AvaotaSBC/AvaotaF1/Hardware/05_BOM/BOM_Avaota F1_PCB1_2025-04-17.xlsx

No. | Device | Name | Designator | Value | Footprint | Manufacturer | Manufacturer Part | Supplier | Supplier Part | Quantity | JLCPCB Price | Pins | Primary Category | Secondary Category | Comment
1 | 2.54PHSM-1X15P |  | H4,H5 |  | 2.54PHSM-1X15P | kinghelm(金航标) | KH-2.54PH180-1X16P-L11.5 | LCSC | C2905491 | 2 | 1.0128 | 30 |  |  | KH-2.54PH180-1X16P-L11.5
2 | 0402ESDA-05N | 0402ESDA-05N | D1,D2 |  | D0402 | BORN(伯恩半导体) | 0402ESDA-05N | LCSC | C316049 | 2 | 0.122 | 2 |  |  | 0402ESDA-05N
3 | AFC11-S16ICC-00 | AFC11-S16ICC-00 | P1 |  | FPC-SMD_16P-L13.5-W2.0-P0.50 | JS(钜硕电子) | AFC11-S16ICC-00 | LCSC | C11071 | 1 | 0.596 | 18 | 连接器 | FFC/FPC连接器 | AFC11-S16ICC-00
4 | CA-C03 | CA-C03 | ANT1 |  | ANT-SMD_CA-C03 |  | CA-C03 | LCSC | C2838842 | 1 | 0.004 | 2 |  |  | CA-C03
5 | CAP_0402 | 100nF | C53,C54,C55,C56,C57,C58,C59,C60,C61,C63 | 100nF | C0402-NSK |  |  |  |  | 10 |  | 2 |  |  | 100nF
6 | CAP_0603 | 22uF | C43,C44,C45,C46,C47,C48,C49,C50,C51,C52 | 22uF | C0603-NSK |  |  |  |  | 10 |  | 2 |  |  | 22uF
7 | CKCS201610-2.2uH/M | 2.2uH | L1,L2,L3 | 2.2uH | IND-SMD_L2.0-W1.6 | CENKER(岑科) | CKCS201610-2.2uH/M | LCSC | C354533 | 3 | 0.233 | 2 | Inductors/Coils/Transformers | Power Inductors | 2.2uH
8 | CL03A104KQ3NNNC | 1uF | C2,C3,C4 | 1uF | C0201 NSK | SAMSUNG(三星) | CL03A104KQ3NNNC | LCSC |  | 3 |  | 2 | 电容 | 贴片电容(MLCC) | 1uF
9 | CL03A104KQ3NNNC | 2.2uF | C25 | 2.2uF | C0201 NSK | SAMSUNG(三星) | CL03A104KQ3NNNC | LCSC |  | 1 |  | 2 | 电容 | 贴片电容(MLCC) | 2.2uF
10 | CL03A104KQ3NNNC | 4.7uF | C1,C29 | 4.7uF | C0201 NSK | SAMSUNG(三星) | CL03A104KQ3NNNC | LCSC |  | 2 |  | 2 | 电容 | 贴片电容(MLCC) | 4.7uF
11 | CL03A104KQ3NNNC | 10pF | C11,C12 | 10pF | C0201 NSK | SAMSUNG(三星) | CL03A104KQ3NNNC | LCSC |  | 2 |  | 2 | 电容 | 贴片电容(MLCC) | 10pF
12 | CL03A104KQ3NNNC | 33pF | C30,C31 | 33pF | C0201 NSK | SAMSUNG(三星) | CL03A104KQ3NNNC | LCSC |  | 2 |  | 2 | 电容 | 贴片电容(MLCC) | 33pF
13 | CL03A104KQ3NNNC | 100nF | C5,C10,C13,C14,C15,C16,C17,C18,C19,C20,C21,C22,C23,C24,C27,C28,C32,C33,C34,C35,C37,C38,C39,C40,C41,C42,C62 | 100nF | C0201 NSK | SAMSUNG(三星) | CL03A104KQ3NNNC | LCSC | C160831 | 27 | 0.0072 | 2 | 电容 | 贴片电容(MLCC) | 100nF
14 | CL03A104KQ3NNNC | 470nF | C26 | 470nF | C0201 NSK | SAMSUNG(三星) | CL03A104KQ3NNNC | LCSC |  | 1 |  | 2 | 电容 | 贴片电容(MLCC) | 470nF
15 | EA3036CQBR | EA3036CQBR | U3 |  | WQFN-20_L3.0-W3.0-P0.40-BL-EP | everanalog(申风) | EA3036CQBR | LCSC | C570857 | 1 | 1.505 | 21 | 电源管理 | 专业电源管理(PMIC) | EA3036CQBR
16 | HDR-F_2.54_1x2P |  | H3 |  | HDR-TH_2P-P2.54-V-F | BOOMELE(博穆精密) | 2.54-1*2P母 | LCSC | C49661 | 1 | 0.248 | 2 | 连接器 | 排母 | 2.54-1*2P母
17 | LED_0807-RGB |  | LED1 |  | RGBLED_0807 |  |  |  |  | 1 |  | 2 |  |  | LED_0807-RGB
18 | MIC-4013-G-G00 | MIC-4013-G-G00 | MIC1 |  | MIC-SMD_MIC-4013-G-G00 | SAMZO(三佐) | MIC-4013-G-G00 | LCSC | C42371093 | 1 | 0.537 | 2 | 音频器件/振动马达 | 咪头/麦克风 | MIC-4013-G-G00
19 | MUP-M617-2 | MUP-M617-2 | U2 |  | TF-SMD_MUP-M617-2 | MUP(德海威) | MUP-M617-2 | LCSC | C5205359 | 1 | 2.41 | 12 | 连接器 | SD卡连接器 | MUP-M617-2
20 | PY25Q128HA-SUH-IT | PY25Q128HA-SUH-IT | U4 |  | SOP-8_L5.2-W5.3-P1.27-LS7.9-BL | PUYA(普冉) | PY25Q128HA-SUH-IT | LCSC | C7419750 | 1 | 3.89 | 8 | 存储器 | NOR FLASH | PY25Q128HA-SUH-IT
21 | Q22FA12800489 | 40MHz | X1 | 40MHz | osc-smd_4p-l2.0-w1.6-bl | EPSON(爱普生) | Q22FA12800489 | LCSC |  | 1 |  | 4 | 晶振/振荡器/谐振器 | 无源晶振 | 40MHz
22 | Res_0201 | 0 | R2,R3 | 0 | R0201 NSK |  |  |  |  | 2 |  | 2 |  |  | 0
23 | Res_0201 | 1K | R22,R23 | 1K | R0201 NSK |  |  |  |  | 2 |  | 2 |  |  | 1K
24 | Res_0201 | 1.5K | R18,R19 | 1.5K | R0201 NSK |  |  |  |  | 2 |  | 2 |  |  | 1.5K
25 | Res_0201 | 2K | R24,R25 | 2K | R0201 NSK |  |  |  |  | 2 |  | 2 |  |  | 2K
26 | Res_0201 | 5.1K | R6,R15,R16 | 5.1K | R0201 NSK |  |  |  |  | 3 |  | 2 |  |  | 5.1K
27 | Res_0201 | 10K | R8,R14,R17,R26 | 10K | R0201 NSK |  |  |  |  | 4 |  | 2 |  |  | 10K
28 | Res_0201 | 33 | R4,R5,R20,R21 | 33 | R0201 NSK |  |  |  |  | 4 |  | 2 |  |  | 33
29 | Res_0201 | 75K | R12 | 75K | R0201 NSK |  |  |  |  | 1 |  | 2 |  |  | 75K
30 | Res_0201 | 100K | R11,R13 | 100K | R0201 NSK |  |  |  |  | 2 |  | 2 |  |  | 100K
31 | Res_0201 | 150K | R9,R10 | 150K | R0201 NSK |  |  |  |  | 2 |  | 2 |  |  | 150K
32 | Res_0201 | 680K | R7 | 680K | R0201 NSK |  |  |  |  | 1 |  | 2 |  |  | 680K
33 | Res_0201 | NC | R1 | NC | R0201 NSK |  |  |  |  | 1 |  | 2 |  |  | NC
34 | Res_0402 | 1 | R27 | 1 | R0402-NSK |  |  |  |  | 1 |  | 2 | 电阻 | 贴片电阻 | 1
35 | TS3425BA | TS3425BA | SW1 |  | SW-SMD_4P-L4.2-W3.2-P2.15-LS4.6-1 | SHOU HAN(首韩) | TS3425BA | LCSC | C2681476 | 1 | 0.226 | 4 | 按键/开关 | 轻触开关 | TS3425BA
36 | TYPE-C 16P QTGM027 | TYPE-C 16P QTGM027 | USB1 |  | USB-C-SMD_TYPE-C-16P-QTGM027 | SHOU HAN(首韩) | TYPE-C 16P QTGM027 | LCSC | C2681552 | 1 | 1.0483 | 16 | 连接器 | USB连接器 | TYPE-C 16P QTGM027
37 | V821x2-xXX | V821x2-xXX | U1 |  | QFN-88_L9.0-W9.0-P0.35-BL-EP5.26 |  |  |  |  | 1 |  | 89 |  |  | V821x2-xXX
