AvaotaSBC/AvaotaF1/Hardware/01_SCH/SCH_Main_2025-04-17.pdf

14 14 13 13 12 12 11 11 10 10 9

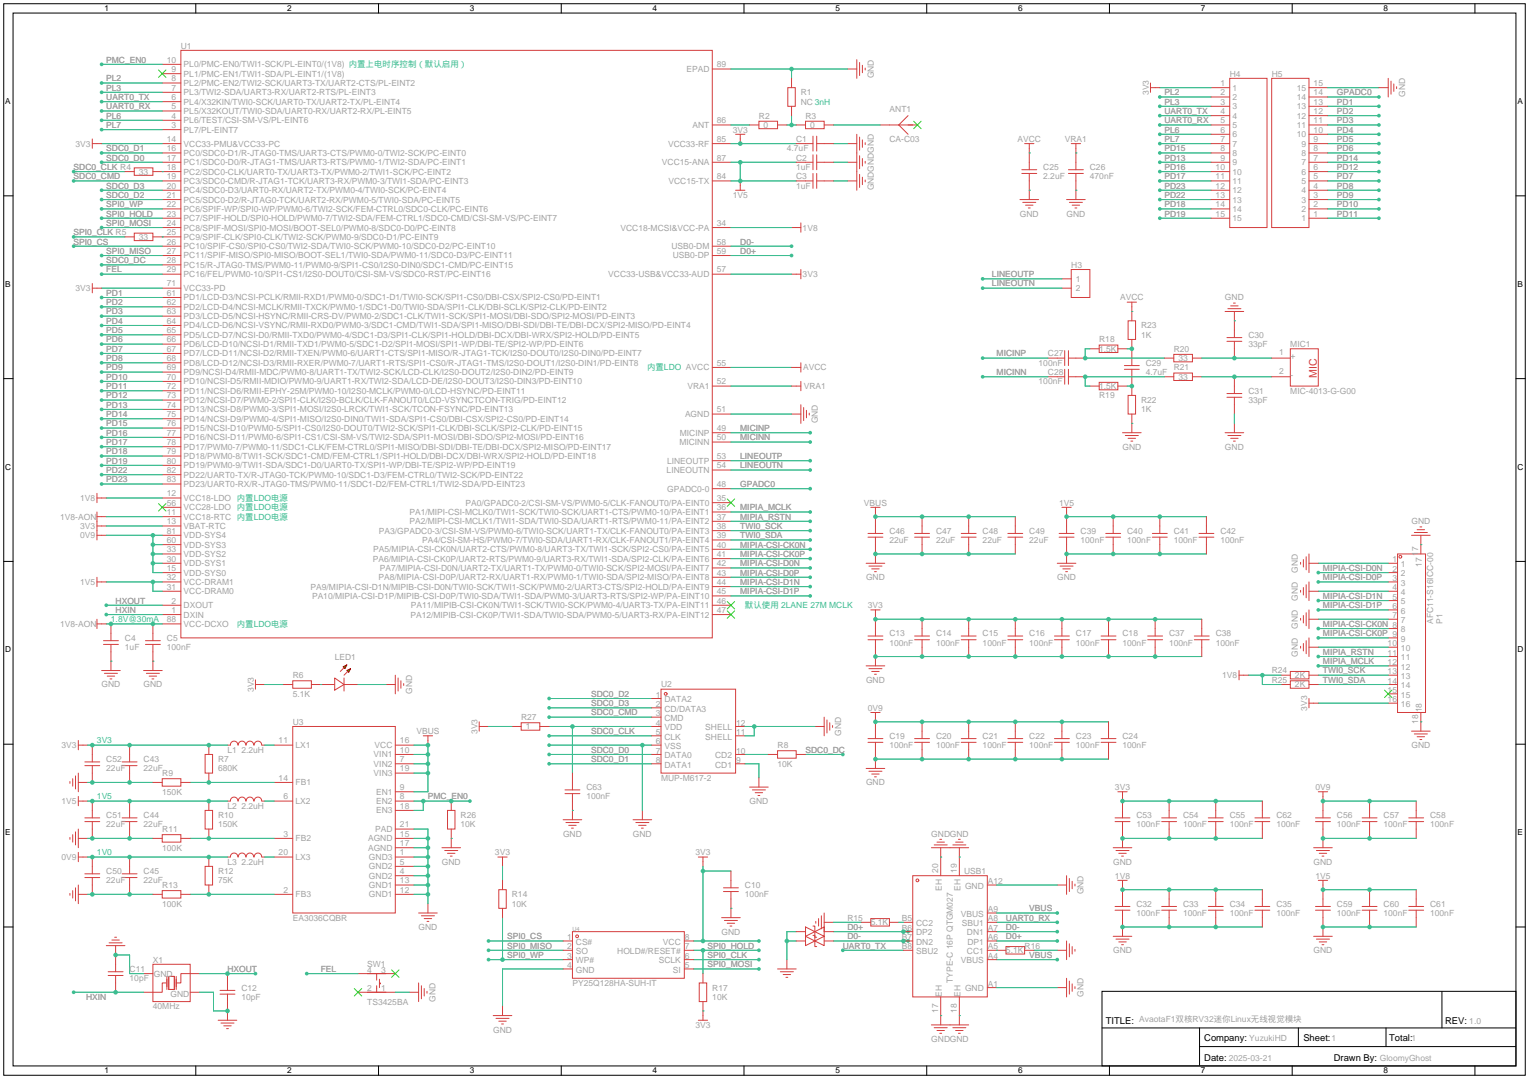
[picture p3: page 1]

PL0/PMC-EN0/TWI1-SCK/PL-EINT0/(1V8) 10
PL1/PMC-EN1/TWI1-SDA/PL-EINT1/(1V8) 9
PL2/PMC-EN2/TWI2-SCK/UART3-TX/UART2-CTS/PL-EINT2 8
PL3/TWI2-SDA/UART3-RX/UART2-RTS/PL-EINT3 7
PL4/X32KIN/TWI0-SCK/UART0-TX/UART2-TX/PL-EINT4 6
PL5/X32KOUT/TWI0-SDA/UART0-RX/UART2-RX/PL-EINT5 5
PL6/TEST/CSI-SM-VS/PL-EINT6 4
PL7/PL-EINT7 3
PC16/FEL/PWM0-10/SPI1-CS1/I2S0-DOUT0/CSI-SM-VS/SDC0-RST/PC-EINT16 29 PC15/R-JTAG0-TMS/PWM0-11/PWM0-9/SPI1-CS0/I2S0-DIN0/SDC1-CMD/PC-EINT15 28 PC11/SPIF-MISO/SPI0-MISO/BOOT-SEL1/TWI0-SDA/PWM0-11/SDC0-D3/PC-EINT11 27 PC10/SPIF-CS0/SPI0-CS0/TWI2-SDA/TWI0-SCK/PWM0-10/SDC0-D2/PC-EINT10 26 PC9/SPIF-CLK/SPI0-CLK/TWI2-SCK/PWM0-9/SDC0-D1/PC-EINT9 25 PC8/SPIF-MOSI/SPI0-MOSI/BOOT-SEL0/PWM0-8/SDC0-D0/PC-EINT8 24 PC7/SPIF-HOLD/SPI0-HOLD/PWM0-7/TWI2-SDA/FEM-CTRL1/SDC0-CMD/CSI-SM-VS/PC-EINT7 23 PC6/SPIF-WP/SPI0-WP/PWM0-6/TWI2-SCK/FEM-CTRL0/SDC0-CLK/PC-EINT6 22 PC5/SDC0-D2/R-JTAG0-TCK/UART2-RX/PWM0-5/TWI0-SDA/PC-EINT5 21 PC4/SDC0-D3/UART0-RX/UART2-TX/PWM0-4/TWI0-SCK/PC-EINT4 20 PC3/SDC0-CMD/R-JTAG1-TCK/UART3-RX/PWM0-3/TWI1-SDA/PC-EINT3 19 PC2/SDC0-CLK/UART0-TX/UART3-TX/PWM0-2/TWI1-SCK/PC-EINT2 18 PC1/SDC0-D0/R-JTAG1-TMS/UART3-RTS/PWM0-1/TWI2-SDA/PC-EINT1 17 PC0/SDC0-D1/R-JTAG0-TMS/UART3-CTS/PWM0-0/TWI2-SCK/PC-EINT0 16 VCC33-PMU&VCC33-PC 14

PD23/UART0-RX/R-JTAG0-TMS/PWM0-11/SDC1-D2/FEM-CTRL1/TWI2-SDA/PD-EINT23 83 PD22/UART0-TX/R-JTAG0-TCK/PWM0-10/SDC1-D3/FEM-CTRL0/TWI2-SCK/PD-EINT22 82 PD19/PWM0-9/TWI1-SDA/SDC1-D0/UART0-TX/SPI1-WP/DBI-TE/SPI2-WP/PD-EINT19 80 PD18/PWM0-8/TWI1-SCK/SDC1-CMD/FEM-CTRL1/SPI1-HOLD/DBI-DCX/DBI-WRX/SPI2-HOLD/PD-EINT18 79 PD17/PWM0-7/PWM0-11/SDC1-CLK/FEM-CTRL0/SPI1-MISO/DBI-SDI/DBI-TE/DBI-DCX/SPI2-MISO/PD-EINT17 78 PD16/NCSI-D11/PWM0-6/SPI1-CS1/CSI-SM-VS/TWI2-SDA/SPI1-MOSI/DBI-SDO/SPI2-MOSI/PD-EINT16 77 PD15/NCSI-D10/PWM0-5/SPI1-CS0/I2S0-DOUT0/TWI2-SCK/SPI1-CLK/DBI-SCLK/SPI2-CLK/PD-EINT15 76 PD14/NCSI-D9/PWM0-4/SPI1-MISO/I2S0-DIN0/TWI1-SDA/SPI1-CS0/DBI-CSX/SPI2-CS0/PD-EINT14 75 PD13/NCSI-D8/PWM0-3/SPI1-MOSI/I2S0-LRCK/TWI1-SCK/TCON-FSYNC/PD-EINT13 74 PD12/NCSI-D7/PWM0-2/SPI1-CLK/I2S0-BCLK/CLK-FANOUT0/LCD-VSYNCTCON-TRIG/PD-EINT12 73 PD11/NCSI-D6/RMII-EPHY-25M/PWM0-10/I2S0-MCLK/PWM0-0/LCD-HSYNC/PD-EINT11 72 PD10/NCSI-D5/RMII-MDIO/PWM0-9/UART1-RX/TWI2-SDA/LCD-DE/I2S0-DOUT3/I2S0-DIN3/PD-EINT10 70 PD9/NCSI-D4/RMII-MDC/PWM0-8/UART1-TX/TWI2-SCK/LCD-CLK/I2S0-DOUT2/I2S0-DIN2/PD-EINT9 69 PD8/LCD-D12/NCSI-D3/RMII-RXER/PWM0-7/UART1-RTS/SPI1-CS0/R-JTAG1-TMS/I2S0-DOUT1/I2S0-DIN1/PD-EINT8 68 PD7/LCD-D11/NCSI-D2/RMII-TXEN/PWM0-6/UART1-CTS/SPI1-MISO/R-JTAG1-TCK/I2S0-DOUT0/I2S0-DIN0/PD-EINT7 67 PD6/LCD-D10/NCSI-D1/RMII-TXD1/PWM0-5/SDC1-D2/SPI1-MOSI/SPI1-WP/DBI-TE/SPI2-WP/PD-EINT6 66 PD5/LCD-D7/NCSI-D0/RMII-TXD0/PWM0-4/SDC1-D3/SPI1-CLK/SPI1-HOLD/DBI-DCX/DBI-WRX/SPI2-HOLD/PD-EINT5 65 PD4/LCD-D6/NCSI-VSYNC/RMII-RXD0/PWM0-3/SDC1-CMD/TWI1-SDA/SPI1-MISO/DBI-SDI/DBI-TE/DBI-DCX/SPI2-MISO/PD-EINT4 64 PD3/LCD-D5/NCSI-HSYNC/RMII-CRS-DV/PWM0-2/SDC1-CLK/TWI1-SCK/SPI1-MOSI/DBI-SDO/SPI2-MOSI/PD-EINT3 63 PD2/LCD-D4/NCSI-MCLK/RMII-TXCK/PWM0-1/SDC1-D0/TWI0-SDA/SPI1-CLK/DBI-SCLK/SPI2-CLK/PD-EINT2 62 PD1/LCD-D3/NCSI-PCLK/RMII-RXD1/PWM0-0/SDC1-D1/TWI0-SCK/SPI1-CS0/DBI-CSX/SPI2-CS0/PD-EINT1 61 VCC33-PD 71

VBAT-RTC 13 VCC18-RTC 11 VCC28-LDO 56 VCC18-LDO 12

PA1/MIPI-CSI-MCLK0/TWI1-SCK/TWI0-SCK/UART1-CTS/PWM0-10/PA-EINT1 36
PA2/MIPI-CSI-MCLK1/TWI1-SDA/TWI0-SDA/UART1-RTS/PWM0-11/PA-EINT2 37
PA3/GPADC0-3/CSI-SM-VS/PWM0-6/TWI0-SCK/UART1-TX/CLK-FANOUT0/PA-EINT3 38
PA5/MIPIA-CSI-CK0N/UART2-CTS/PWM0-8/UART3-TX/TWI1-SCK/SPI2-CS0/PA-EINT5 40
PA6/MIPIA-CSI-CK0P/UART2-RTS/PWM0-9/UART3-RX/TWI1-SDA/SPI2-CLK/PA-EINT6 41
PA7/MIPIA-CSI-D0N/UART2-TX/UART1-TX/PWM0-0/TWI0-SCK/SPI2-MOSI/PA-EINT7 42
PA8/MIPIA-CSI-D0P/UART2-RX/UART1-RX/PWM0-1/TWI0-SDA/SPI2-MISO/PA-EINT8 43

PA0/GPADC0-2/CSI-SM-VS/PWM0-5/CLK-FANOUT0/PA-EINT0 35

VDD-SYS0 15 VDD-SYS1 30 VDD-SYS2 33 VDD-SYS3 60 VDD-SYS4 81

PA4/CSI-SM-HS/PWM0-7/TWI0-SDA/UART1-RX/CLK-FANOUT1/PA-EINT4 39

GND GND

PA9/MIPIA-CSI-D1N/MIPIB-CSI-D0N/TWI0-SCK/TWI1-SCK/PWM0-2/UART3-CTS/SPI2-HOLD/PA-EINT9 44
PA10/MIPIA-CSI-D1P/MIPIB-CSI-D0P/TWI0-SDA/TWI1-SDA/PWM0-3/UART3-RTS/SPI2-WP/PA-EINT10 45

PA11/MIPIB-CSI-CK0N/TWI1-SCK/TWI0-SCK/PWM0-4/UART3-TX/PA-EINT11 46
PA12/MIPIB-CSI-CK0P/TWI1-SDA/TWI0-SDA/PWM0-5/UART3-RX/PA-EINT12 47
