AvaotaSBC/AvaotaF1/(list of files, drawings)

Other design files:
Hardware/02_PCB/ProDoc_Avaota F1_2025-04-17.epro
